NoggeOomNiel/DataSafe_PIO_Enc_RTC/DataSafe Schematic.png

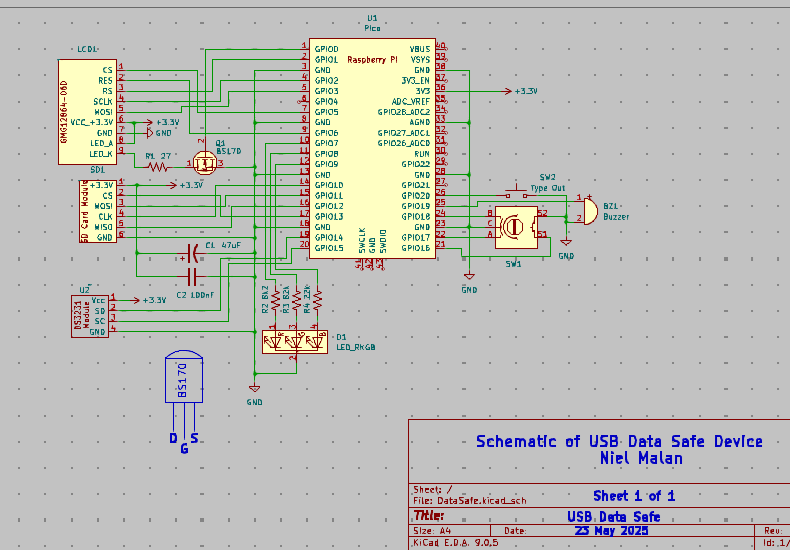
DataSafe Schematic.png
