NoggeOomNiel/DataSafe_PIO_Enc_RTC/3D print/Front_Left_View.png

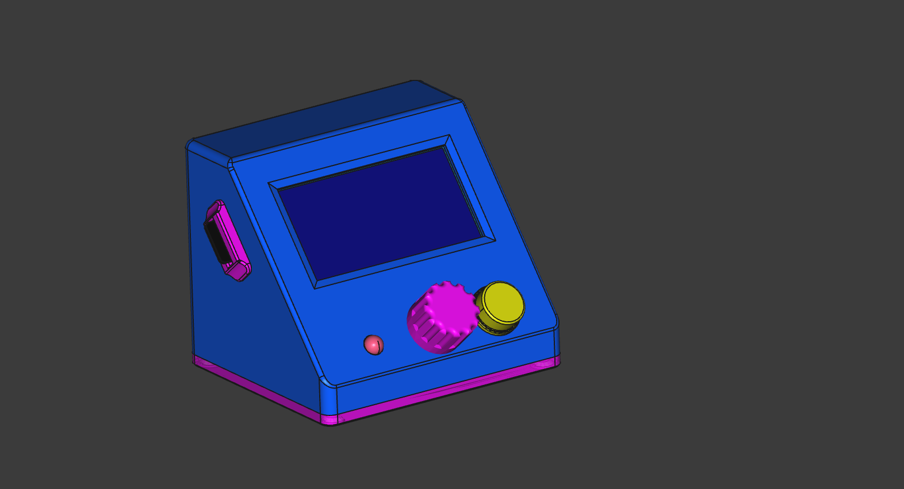
3D print/Front_Left_View.png
