NoggeOomNiel/DataSafe_PIO_Enc_RTC/3D print/Front_Right_View.png

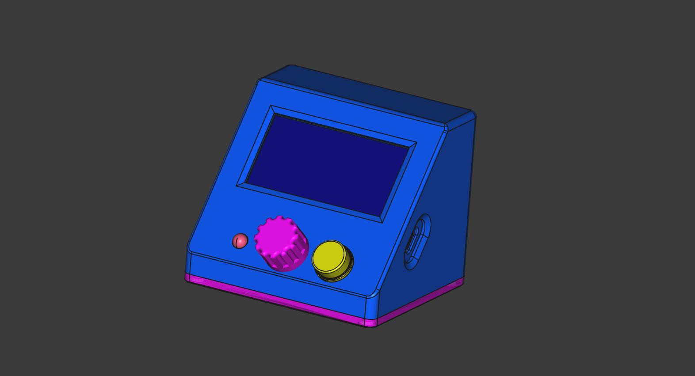
3D print/Front_Right_View.png
