NoggeOomNiel/DataSafe_PIO_Enc_RTC/3D print/Inside_View.png

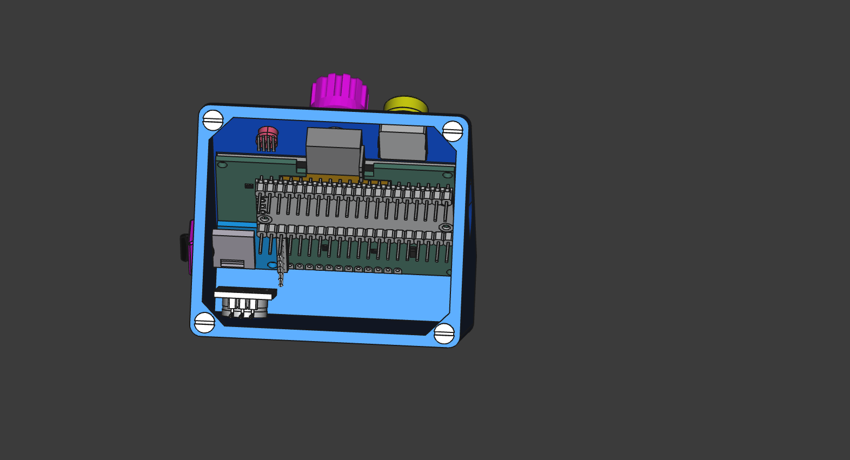
3D print/Inside_View.png
