NoggeOomNiel/DataSafe_PIO_Enc_RTC/3D print/Rear_View.png

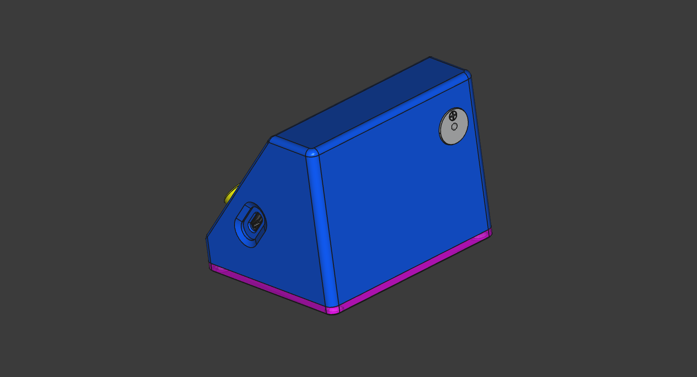
3D print/Rear_View.png
