NoggeOomNiel/DataSafe_PIO_Enc_RTC/(commit log)

2025-11-21 Add files via upload
    Updated Schematic
2025-11-21 Update README with 3D printing resources
    Added images and GCODE files for 3D printing.
2025-11-30 Rename FileSafe-Box.gcode to 3D print/FileSafe-Box.gcode
2025-11-30 Update and rename FileSafe-bottom etc.gcode to 3D print/FileSafe-bottom etc.gcode
2025-11-30 Rename Front_Left_View.png to 3D print/Front_Left_View.png
2025-11-30 Rename Front_Right_View.png to 3D print/Front_Right_View.png
2025-11-30 Rename Rear_View.png to 3D print/Rear_View.png
2025-11-30 Rename Inside_View.png to 3D print/Inside_View.png
2025-12-07 DataSafePlus app with Manual login
    Create your own Windows desktop vb.net app using .NET 8 or higher. Add the ds*.* files to the app. This version does not use web automation and therefore does not need to be signed. The user can mouse-middle-click on the Username and Password columns cells to automatically paste the contents to the web page current active control element. Clicking on the Web Page cell will attempt to open a web browser to the page location in the cell.
